Aryan-git-byte/SoilMetrics-Lite/production/BOM.csv

Reference | Qty | Value | Footprint | Price | Link
C1,C2,C5,C6 | 4 | 100nF | Capacitor_SMD:C_0805_2012Metric_Pad1.18x1.45mm_HandSolder | 0.97 | http://robu.in/product/tcc0805x7r104k500dt-cctc-smt-ceramic-capacitors-0805-x7r-104k100nf%C2%B110-rated-voltage50v-thickness0-85mmtape/
C3,C4 | 2 | 22pF | Capacitor_SMD:C_0805_2012Metric_Pad1.18x1.45mm_HandSolder | 1.56 | https://robu.in/product/mcmt21n220f250ct-yageo-smd-multilayer-ceramic-capacitor-22-pf-25-v-0805-2012-metric-%C2%B1-1-c0g-np0-mcmt/
D1 | 1 | Red | LED_THT:LED_D3.0mm | 1.51 | https://robu.in/product/3mm-red-dip-led-pack-of-50/
D2 | 1 | yellow | LED_THT:LED_D3.0mm | 1 | https://robu.in/product/3-mm-dip-led-yellow-50-pcs/
D3 | 1 | green | LED_THT:LED_D3.0mm | 1.35 | https://robu.in/product/3mm-green-dip-led-pack-of-50/
J1 | 1 | USB_C_Receptacle_USB2.0_16P | Connector_USB:USB_C_Receptacle_GCT_USB4105-xx-A_16P_TopMnt_Horizontal | 38 | http://robu.in/product/type-c-31-m-12-hroparts-5a-1-16p-female-type-c-smd-usb-connectors-rohs/
J2 | 1 | Conn_01x04 | Connector_PinHeader_2.54mm:PinHeader_1x04_P2.54mm_Vertical
J3 | 1 | Conn_02x03_Odd_Even | Connector_PinHeader_2.54mm:PinHeader_2x03_P2.54mm_Vertical | 3.44 | https://robu.in/product/ds1021-2x3sf11-b-connfly-2x3-pin-2-54mm-pin-header-v-t-type/
R1,R2 | 2 | 5.1K | Resistor_SMD:R_0805_2012Metric_Pad1.20x1.40mm_HandSolder | 1.57 | https://robu.in/product/af0805fr-075k1l-yageo-5-1k%CF%89-%C2%B11-125mw-thick-film-%C2%B1100ppm-%E2%84%83-0805-chip-resistor-surface-mount-rohs/
R3 | 1 | 10K | Resistor_SMD:R_0805_2012Metric_Pad1.20x1.40mm_HandSolder | 0.80 | https://robu.in/product/rc0805fr-0710kl-yageo-res-thick-film-0805-10k-ohm-1-0-125w1-8w-%C2%B1100ppm-c-pad-smd-t-r/
R4 | 1 | 1K | Resistor_SMD:R_0805_2012Metric_Pad1.20x1.40mm_HandSolder | 0.54 | https://robu.in/product/1k-ohm-1-4w-0805-surface-mount-chip-resistor-pack-of-10/
R5,R6 | 2 | 330 | Resistor_SMD:R_0805_2012Metric_Pad1.20x1.40mm_HandSolder | 0.80 | https://robu.in/product/rc0805fr-07330rl-yageo-res-thick-film-0805-330-ohm-1-0-125w1-8w-%25c2%25b1100ppm-c-pad-smd-t-r/
SW1 | 1 | SW_Push | Button_Switch_THT:SW_TH_Tactile_Omron_B3F-107x | 3.81 | https://robu.in/product/362-5mm-tactile-push-button-switch-20pcs/
U1 | 1 | MAX485E | Package_SO:SOIC-8_3.9x4.9mm_P1.27mm | 24 | https://robu.in/product/max485edtr-xblw-sop-8-rs-485-rs-422-ics-rohs/
U2 | 1 | CH340C | Package_SO:SOIC-16_3.9x9.9mm_P1.27mm | 45 | https://techiesms.com/product/ch340c-usb-to-serial-converter-ic-sop16/
U3 | 1 | ATmega328P-P | Package_DIP:DIP-28_W7.62mm | 339 | https://robu.in/product/atmega328p-pu-pdip-28-microcontroller/
Y1 | 1 | 16MHz | Crystal:Crystal_HC49-4H_Vertical | 8 | https://robu.in/product/hc49-s-16mhz-crystal-oscillator-pack-of-5/
