Aryan-git-byte/SoilMetrics-Lite/cad/step/Top.step

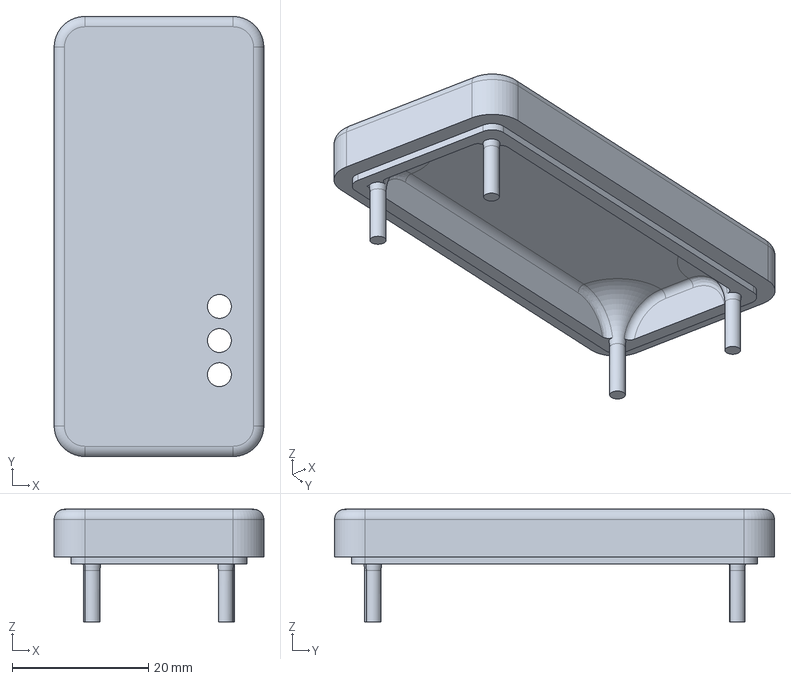
[picture p6: CAD file, 2026-07-16]
cad/step/Top.step
30.8 x 64.5 x 16.5 mm
