Aryan-git-byte/SoilMetrics-Lite/cad/step/pcb.step

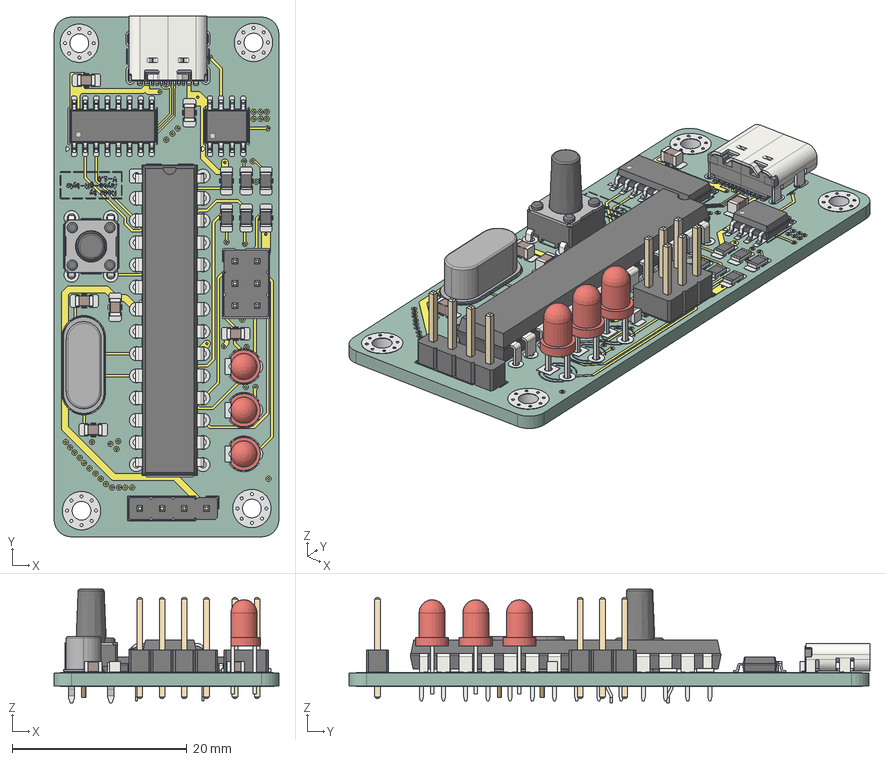
[picture p7: CAD file, 2026-07-16]
cad/step/pcb.step
25.8 x 59.6 x 13.0 mm
SW_TH_Tactile_Omron_B3F-107x
DIP-28_W7.62mm
R_0805_2012Metric x 6
C_0805_2012Metric x 6
SOIC-16_3.9x9.9mm_P1.27mm
LED_D3.0mm x 3
SOIC-8_3.9x4.9mm_P1.27mm
Crystal_HC49-4H_Vertical
PinHeader_1x04_P254mm_Vertical
USB_C_Receptacle_16P_TopMnt_Horizontal_GCT_USB4105-xx-A
PinHeader_2x03_P254mm_Vertical
src_copper
src_pad
src_via
src_silkscreen x 2
src_PCB
