Aryan-git-byte/SoilMetrics-Lite/cad/step/Bottom.step

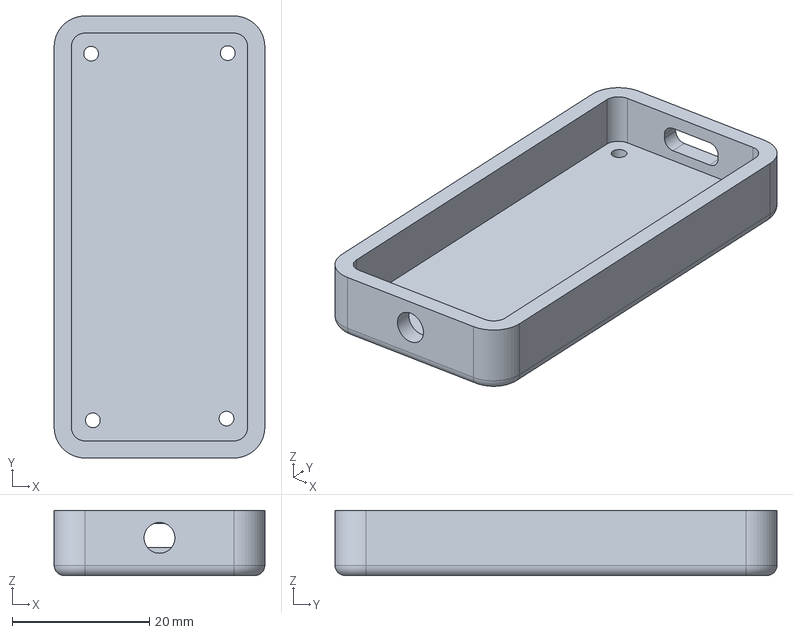
[picture p8: CAD file, 2026-07-16]
cad/step/Bottom.step
30.8 x 64.5 x 9.50 mm
