Aryan-git-byte/SoilMetrics-Lite/(list of files, cad)

Other CAD files:
Blender/src.blend
cad/fusion/Bottom.f3d
cad/fusion/Top.f3d
