Aryan-git-byte/SoilMetrics-Lite/schematic.pdf

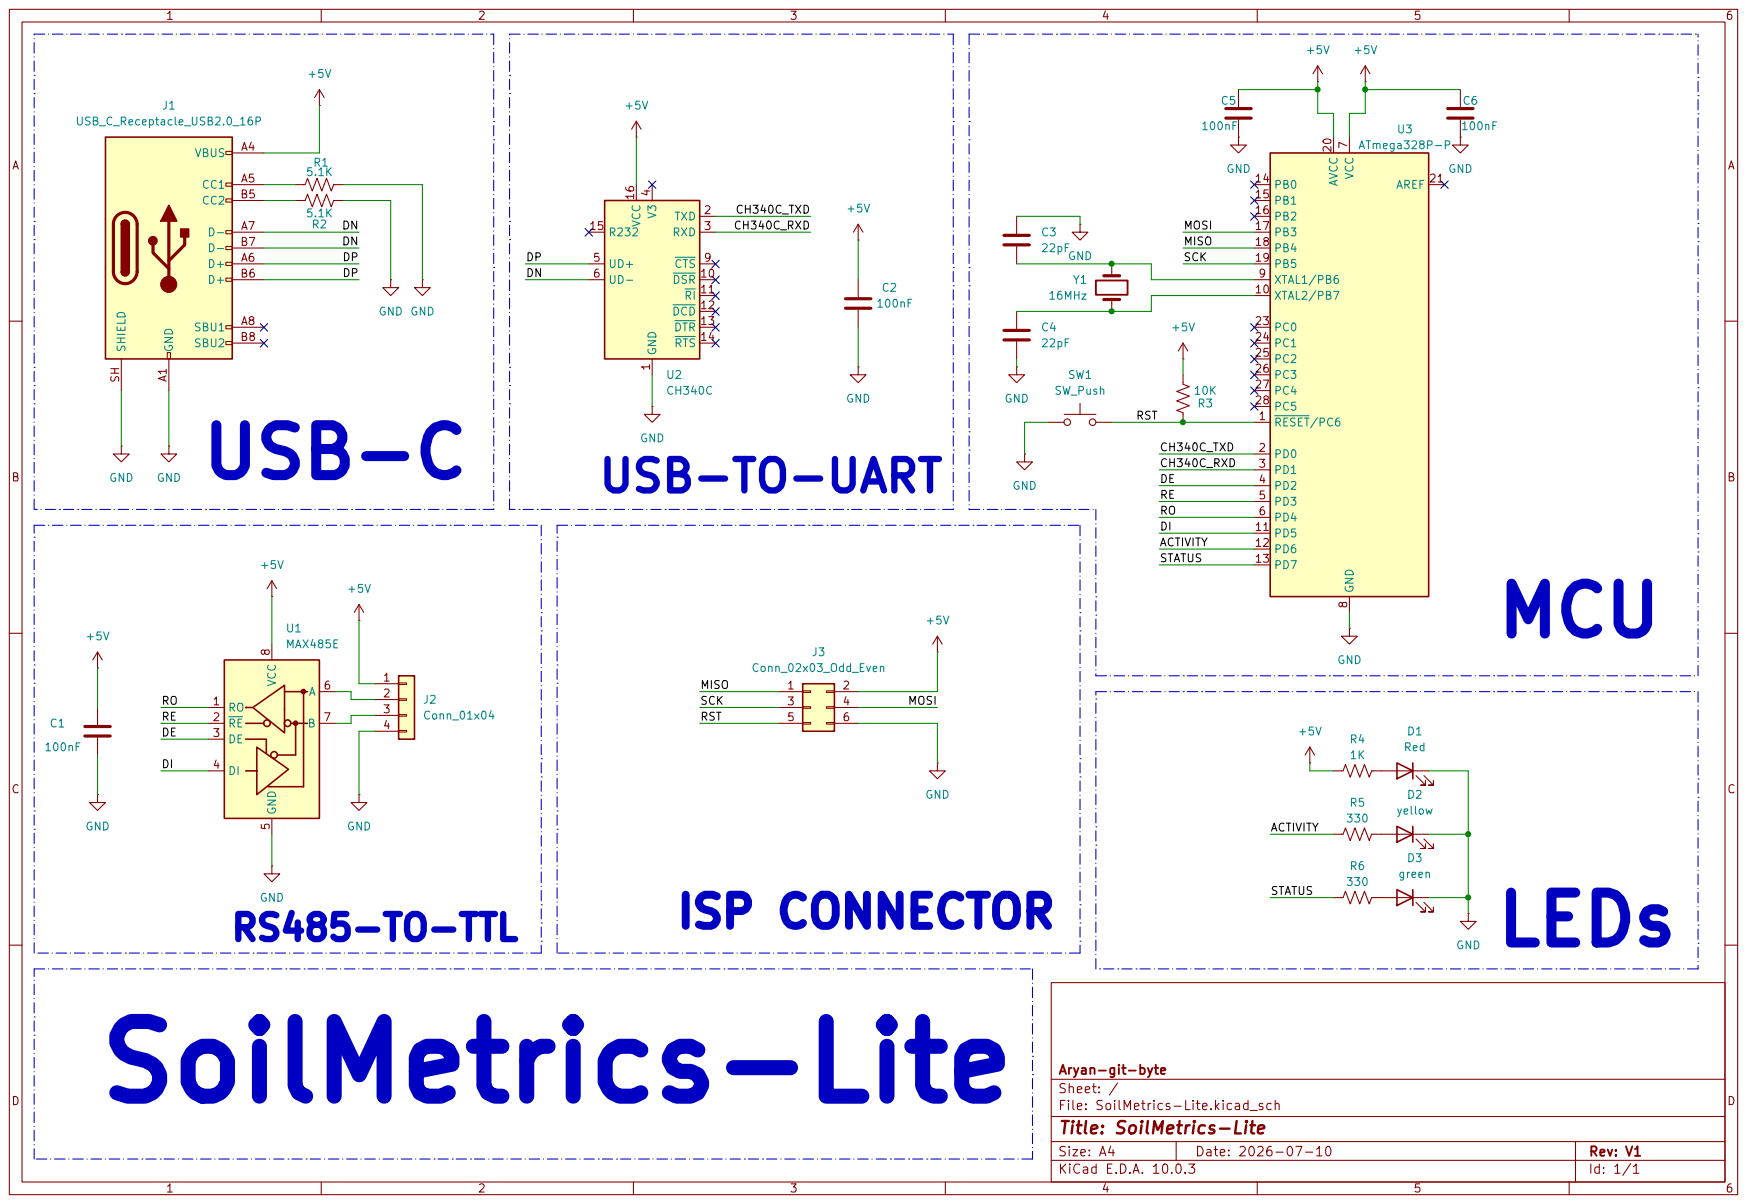
[picture p9: page 1]
