Aryan-git-byte/SoilMetrics-Lite/pcb/SoilMetrics-Lite.kicad_pcb

## KiCad design pcb/SoilMetrics-Lite.kicad_pcb (2026-07-16)

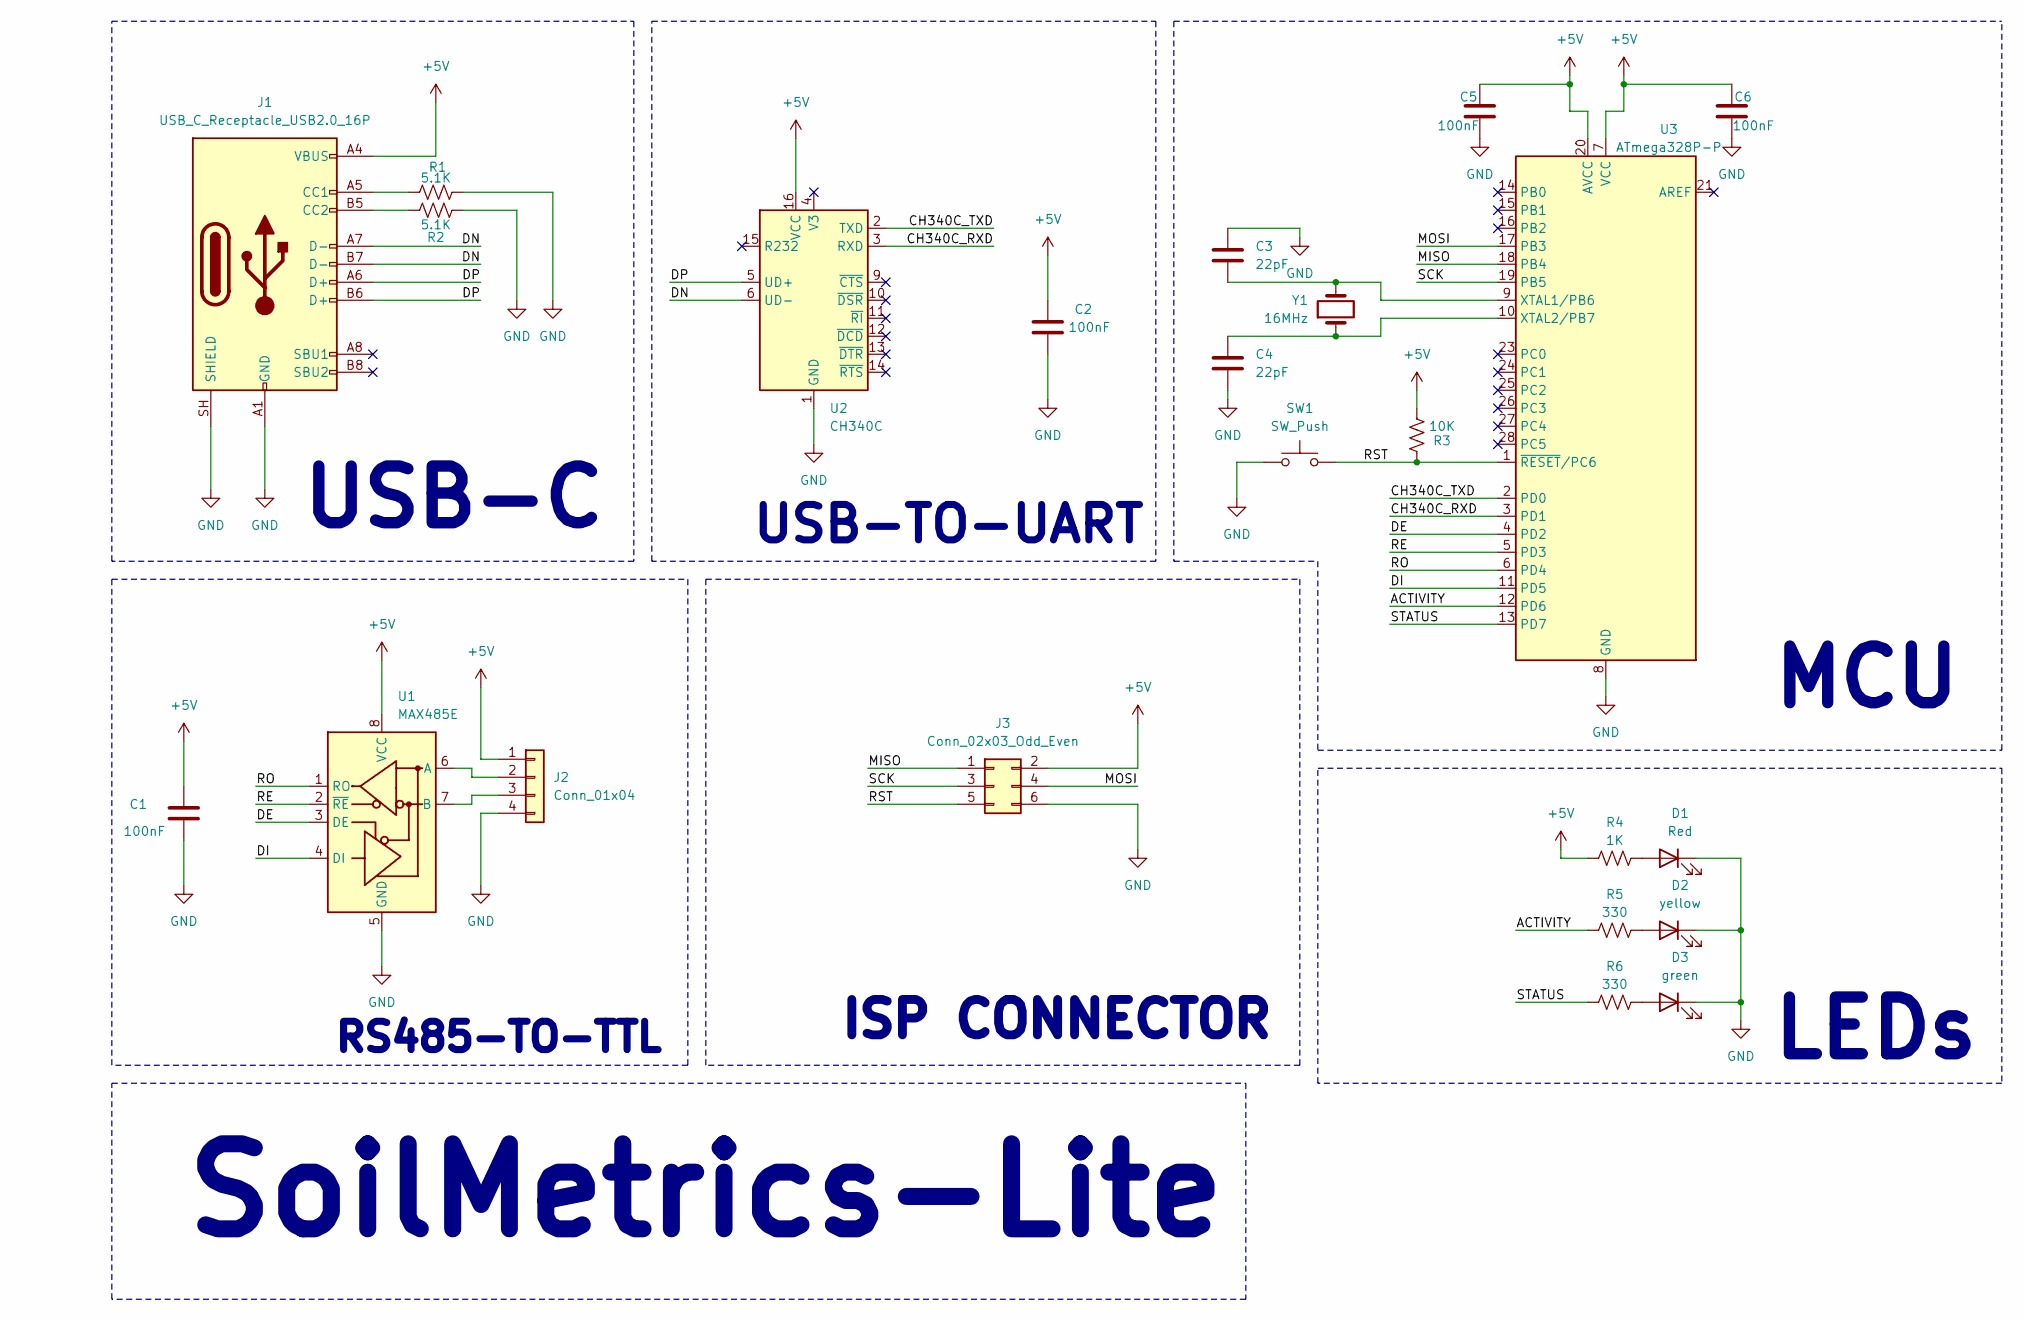
[picture p10: schematic SoilMetrics-Lite.kicad_sch]

Parts:
C1, C2, C5, C6: 100nF; C_0805_2012Metric_Pad1.18x1.45mm_HandSolder
C3, C4: 22pF; C_0805_2012Metric_Pad1.18x1.45mm_HandSolder
D1: Red; LED_D3.0mm
D2: yellow; LED_D3.0mm
D3: green; LED_D3.0mm
J1: USB_C_Receptacle_USB2.0_16P; USB_C_Receptacle_GCT_USB4105-xx-A_16P_TopMnt_Horizontal
J2: Conn_01x04; PinHeader_1x04_P2.54mm_Vertical
J3: Conn_02x03_Odd_Even; PinHeader_2x03_P2.54mm_Vertical
R1, R2: 5.1K; R_0805_2012Metric_Pad1.20x1.40mm_HandSolder
R3: 10K; R_0805_2012Metric_Pad1.20x1.40mm_HandSolder
R4: 1K; R_0805_2012Metric_Pad1.20x1.40mm_HandSolder
R5, R6: 330; R_0805_2012Metric_Pad1.20x1.40mm_HandSolder
SW1: SW_Push; SW_TH_Tactile_Omron_B3F-107x
U1: MAX485E; SOIC-8_3.9x4.9mm_P1.27mm
U2: CH340C; SOIC-16_3.9x9.9mm_P1.27mm
U3: ATmega328P-P; DIP-28_W7.62mm
Y1: 16MHz; Crystal_HC49-4H_Vertical

Connections:
+5V: C1.1, C2.1, C5.1, C6.1, J1.A4 (VBUS), J1.A9 (VBUS), J1.B4 (VBUS), J1.B9 (VBUS), J2.1, J3.2, R3.1, R4.1, U1.8 (VCC), U2.16 (VCC), U3.7 (VCC), U3.20 (AVCC)
/ACTIVITY: R5.1, U3.12 (PD6)
/CH340C_RXD: U2.3 (RXD), U3.3 (PD1)
/CH340C_TXD: U2.2 (TXD), U3.2 (PD0)
/DE: U1.3 (DE), U3.4 (PD2)
/DI: U1.4 (DI), U3.11 (PD5)
/DN: J1.A7 (D-), J1.B7 (D-), U2.6 (UD-)
/DP: J1.A6 (D+), J1.B6 (D+), U2.5 (UD+)
/MISO: J3.1, U3.18 (PB4)
/MOSI: J3.4, U3.17 (PB3)
/RE: U1.2 (~RE), U3.5 (PD3)
/RO: U1.1 (RO), U3.6 (PD4)
/RST: J3.5, R3.2, SW1.2, U3.1 (~RESET/PC6)
/SCK: J3.3, U3.19 (PB5)
/STATUS: R6.1, U3.13 (PD7)
GND: C1.2, C2.2, C3.1, C4.2, C5.2, C6.2, D1.1 (K), D2.1 (K), D3.1 (K), J1.A1 (GND), J1.A12 (GND), J1.B1 (GND), J1.B12 (GND), J1.SH (SHIELD), J2.4, J3.6, R1.2, R2.1, SW1.1, U1.5 (GND), U2.1 (GND), U3.8 (GND), U3.22 (GND)
unnamed: D1.2 (A), R4.2
unnamed: D2.2 (A), R5.2
unnamed: D3.2 (A), R6.2
unnamed: J1.A5 (CC1), R1.1
unnamed: J1.B5 (CC2), R2.2
unnamed: J2.2, U1.6 (A)
unnamed: J2.3, U1.7 (B)
unnamed: C3.2, U3.9 (XTAL1/PB6), Y1.2
unnamed: C4.1, U3.10 (XTAL2/PB7), Y1.1

Notes on the sheet:
SoilMetrics-Lite
USB-C
LEDs
ISP CONNECTOR
RS485-TO-TTL
MCU
USB-TO-UART

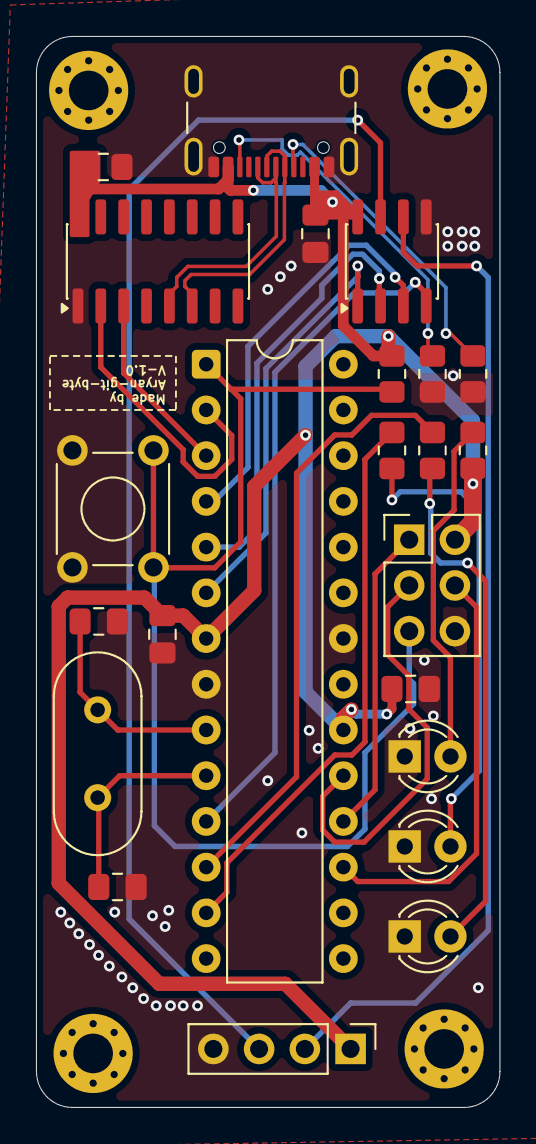
[picture p11: board SoilMetrics-Lite.kicad_pcb from above]

Board: 2 copper layers, 25.8 x 59.5 mm, 23 parts (0 on the bottom side), 25 nets.
