Aryan-git-byte/SoilMetrics-Lite/(commit log)

2026-07-16 git init
    [Bottom.f3d, Bottom.step, Top.f3d, Top.step, pcb.step, src.blend, src.kicad_pcb, src.kicad_sch]
2026-07-16 update name
    [src.kicad_pcb, src.kicad_sch]
2026-07-16 added gerber and bom
    [SoilMetrics-Lite.csv, SoilMetrics-Lite.kicad_pcb, SoilMetrics-Lite.kicad_sch]
2026-07-16 added readme.md
    [BOM.csv, SoilMetrics-Lite.csv, src.blend]
